mohamedtaherno22-cmyk/MIDI-Keyboard/BOM.csv

Item | Qty | Supplier | Cost/item | Total Cost | link
ESP-32S 30Pin Development Board WiFi Bluetooth with New CP2102 Chip | 1 | RAM electronics | $5.08 | $5.08 | https://www.ram-e-shop.com/shop/kit-esp32-esp32s-30pin-esp-32s-30pin-development-board-wifi-bluetooth-with-new-cp2102-chip-7433
EC11 Rotary Encoder With Push Button Switch 5pin 20mm Silver | 3 | RAM electronics | $0.45 | $1.35 | https://www.ram-e-shop.com/shop/pot-ec11-rotary-5pin-20mm-ec11-rotary-encoder-with-push-button-switch-5pin-20mm-silver-9624
Linear Slide Potentiometer 20KOhm 20mm | 2 | Amazon | $1.45 | $2.90 | https://www.amazon.eg/-/en/Linear-Slide-Potentiometer-20KOhm-20mm/dp/B0CJ885TVL/ref=sr_1_6?sr=8-6
Resistor 10K ohm – 1/4W (2pcs) | 2 | amazon | $0.91 | $1.82 | https://www.amazon.eg/-/en/Resistor-10K-ohm-4W-2pcs/dp/B0CJQ3BYFY/ref=sr_1_8?sr=8-8
(3Pcs) Mechanical Keyboard Switch 5 Pin Cyan Linear 40g Actuation 50M Keystrokes | Mechanical Keyboard Switch Pin Cyan L | 1 | Amazon | $4.06 | $4.06 | https://www.amazon.eg/-/en/Mechanical-Actuation-Keystrokes-enthusiasts-construction/dp/B0GXSY4S7W
(1Pcs) Mechanical Keyboard Switch 5 Pin Cyan Linear 40g Actuation 50M Keystrokes | Mechanical Keyboard Switch Pin Cyan L | 1 | Amazon | $1.92 | $1.92 | https://www.amazon.eg/-/en/Mechanical-Actuation-Keystrokes-enthusiasts-construction/dp/B0GXT298X9
Estimated total shipping | 1 |  |  | $0.00
