mohamedtaherno22-cmyk/MIDI-Keyboard/3DModels/PTA2043.step

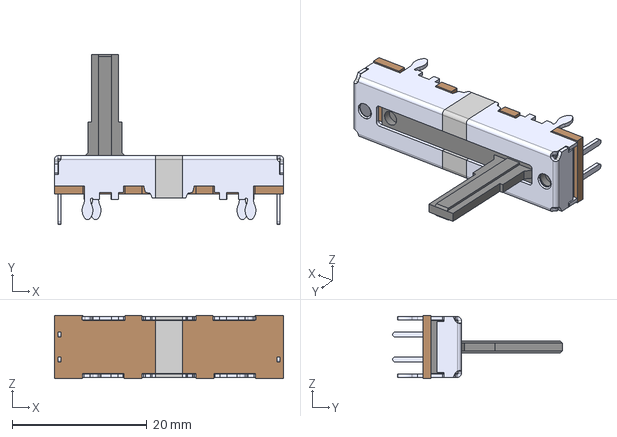
[picture p1: CAD file, 2026-10-25]
3DModels/PTA2043.step
34.0 x 25.2 x 9.40 mm
