mohamedtaherno22-cmyk/MIDI-Keyboard/3DModels/Cherry MX.STEP

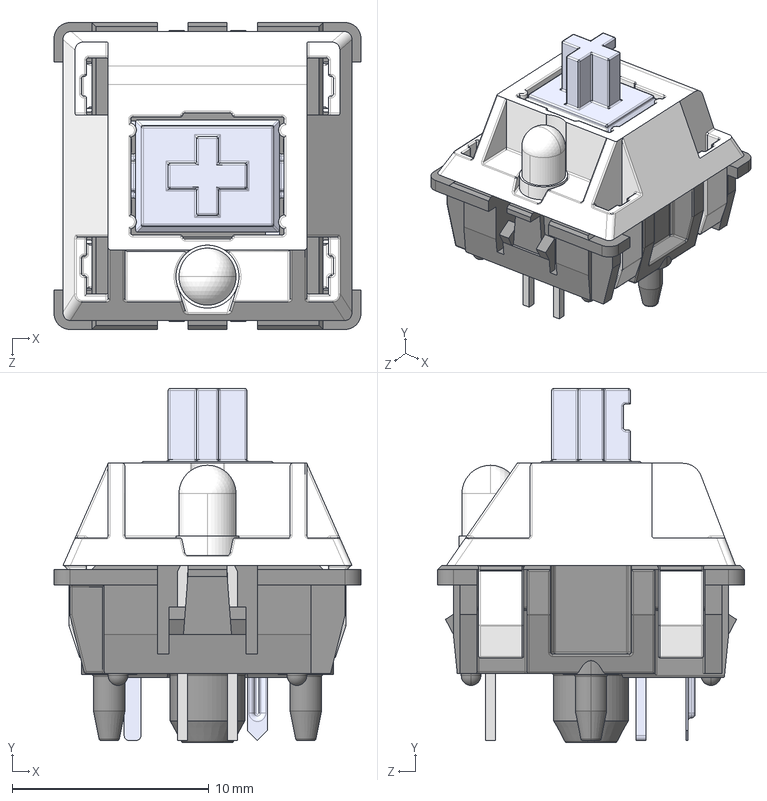
[picture p2: CAD file, 2026-10-25]
3DModels/Cherry MX.STEP
15.6 x 18.0 x 15.6 mm
Bottom
Pulsador
Top
Pieza5^Cherry MX
Pin1
Pin2
Led 3mm_trans
