mohamedtaherno22-cmyk/MIDI-Keyboard/3DModels/usb-micro_esp32_30pinpin.step

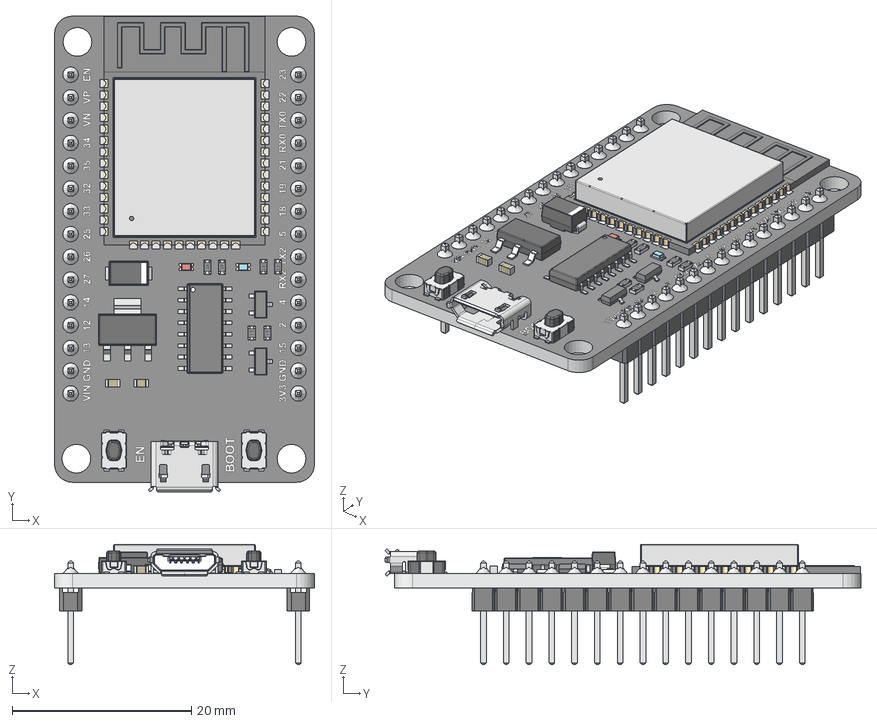
[picture p3: CAD file, 2026-10-25]
3DModels/usb-micro_esp32_30pinpin.step
29.0 x 53.1 x 13.4 mm
690t505-662-010_1
pin
soudures
