mohamedtaherno22-cmyk/MIDI-Keyboard/3DModels/EC11 Rotary Encoder.STEP

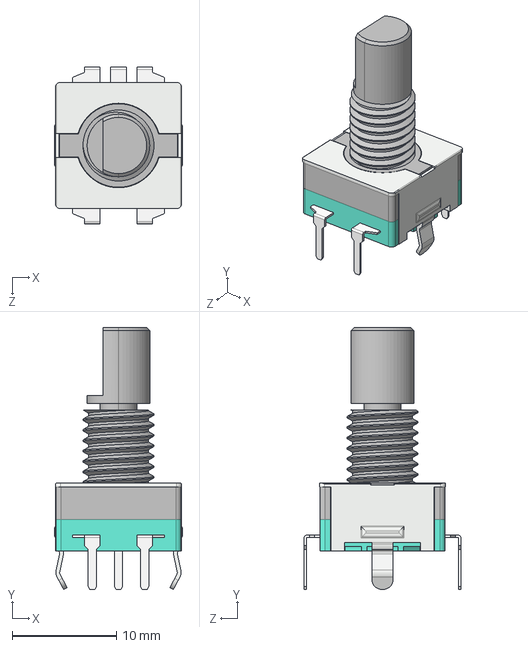
[picture p4: CAD file, 2026-10-25]
3DModels/EC11 Rotary Encoder.STEP
12.3 x 25.1 x 15.0 mm
