mohamedtaherno22-cmyk/MIDI-Keyboard/Schematic & PCB Files/MIDI_Keypad_140mm.kicad_pcb

## KiCad design Schematic & PCB Files/MIDI_Keypad_140mm.kicad_pcb (2026-10-25)

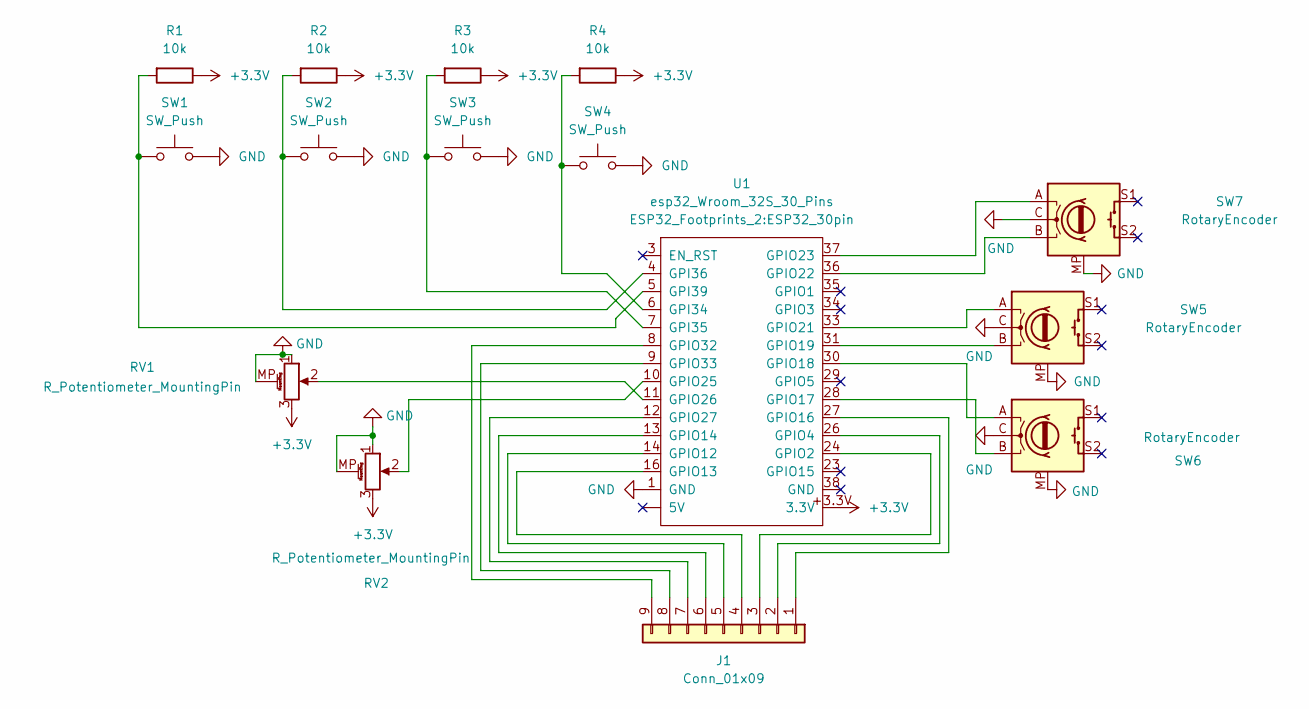
[picture p5: schematic MIDI_Keypad_140mm.kicad_sch]

Parts:
J1: Conn_01x09; Touch Keys
R1, R2, R3, R4: 10k; R_Axial_DIN0207_L6.3mm_D2.5mm_P10.16mm_Horizontal
RV1, RV2: R_Potentiometer_MountingPin; Potentiometer_Bourns_PTA2043_Single_Slide
SW1, SW2, SW3, SW4: SW_Push; SW_Cherry_MX_1.00u_PCB
SW5, SW6, SW7: RotaryEncoder; RotaryEncoder_Alps_EC11E-Switch_Vertical_H20mm
U1: esp32_Wroom_32S_30_Pins; ESP32_30pin

Connections:
+3.3V: R1.1, R2.1, R3.1, R4.1, RV1.3, RV2.3, U1.+3.3V (3.3V)
GND: RV1.1, RV1.MP (MountPin), RV2.1, RV2.MP (MountPin), SW1.2, SW2.2, SW3.2, SW4.2, SW5.C, SW5.MP, SW6.C, SW6.MP, SW7.C, SW7.MP, U1.1 (GND)
unnamed: J1.1, U1.27 (GPIO16)
unnamed: J1.2, U1.26 (GPIO4)
unnamed: J1.3, U1.24 (GPIO2)
unnamed: J1.4, U1.16 (GPIO13)
unnamed: J1.5, U1.14 (GPIO12)
unnamed: J1.6, U1.13 (GPIO14)
unnamed: J1.7, U1.12 (GPIO27)
unnamed: J1.8, U1.9 (GPIO33)
unnamed: J1.9, U1.8 (GPIO32)
unnamed: R4.2, SW4.1, U1.6 (GPI34)
unnamed: R3.2, SW3.1, U1.7 (GPI35)
unnamed: R2.2, SW2.1, U1.4 (GPI36)
unnamed: R1.2, SW1.1, U1.5 (GPI39)
unnamed: SW6.B, U1.28 (GPIO17)
unnamed: SW6.A, U1.30 (GPIO18)
unnamed: SW5.B, U1.31 (GPIO19)
unnamed: SW5.A, U1.33 (GPIO21)
unnamed: SW7.B, U1.36 (GPIO22)
unnamed: SW7.A, U1.37 (GPIO23)
unnamed: RV2.2, U1.10 (GPIO25)
unnamed: RV1.2, U1.11 (GPIO26)

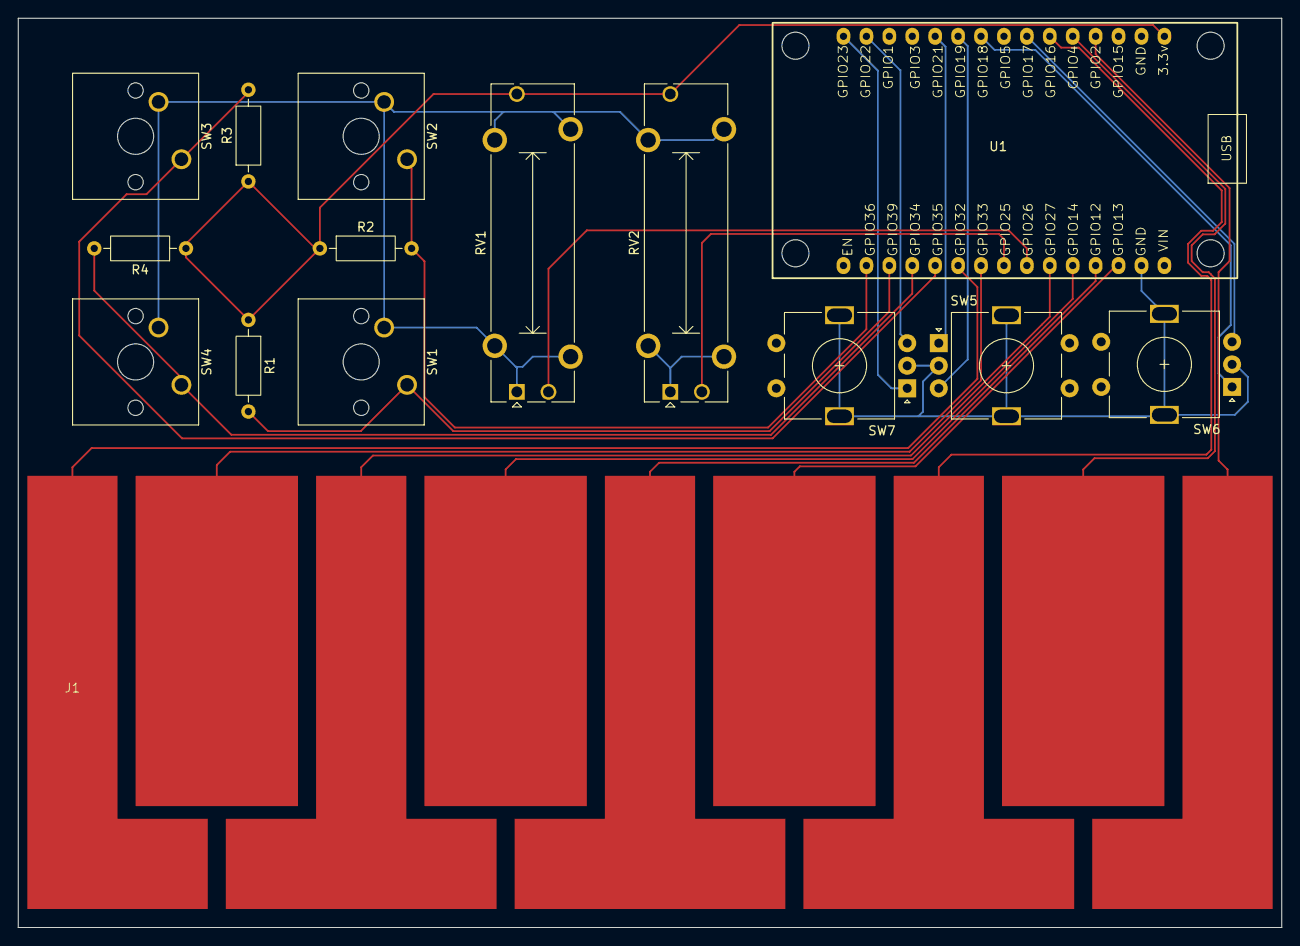
[picture p6: board MIDI_Keypad_140mm.kicad_pcb from above]

Board: 2 copper layers, 140.0 x 100.8 mm, 15 parts (0 on the bottom side), 23 nets.
