mohamedtaherno22-cmyk/MIDI-Keyboard/JOURNAL.md

# Midi Keyboard – devlog

<!-- Generated by Half Life from project cmvf5efq30aw801rct4f9qcgi. Edits here are overwritten on the next sync. -->
<!-- Generated: 2026-10-25T17:37:09.938Z -->

> [!NOTE]
> This devlog is mirrored from [Half Life](https://halflife.hackclub.com) – [open the project](https://halflife.hackclub.com/projects/cmvf5efq30aw801rct4f9qcgi). Editing it here will not change the platform's copy, and the next sync overwrites this file.

> Learn PCB design by creating your own custom MIDI keypad with switches, sliders, rotary encoders, neopixels and capacitive touch!

| Week | Tier | Hours logged | Entries |
| --- | --- | --- | --- |
| Week 3 | Tier 1 | 18h | 3 |

## Contents

1. [2026-10-23 – 22 OCT-OCT24: PCB design.](#2026-10-23-22-oct-oct24-pcb-design)
2. [2026-10-24 – In the last session i faced a problem routing the PCB, the connections were mixed up, i traced the problem to the custom ESP32 Footprint i downloaded, all the pins are mixed up](#2026-10-24-in-the-last-session-i-faced-a-problem-routing-the)
3. [2026-10-25 – OCT 25: 100 mm x 100 mm PCB design](#2026-10-25-oct-25-100-mm-x-100-mm-pcb-design)

## Design

### 2026-10-23 – 22 OCT-OCT24: PCB design.

**12h**

22 OCT-OCT24: PCB design.

The first thing I did this time was open the guide created by Hack Club members. I downloaded symbols, footprints, and and 3d models required for the project and successfully added them to KiCad.

With this, I can start designing the schematic, but before that I had to make a choice: either use the XIAO ESP32-S3 or the Waveshare ESP32-S3-Zero. I found the S3 on Amazon. So I am sticking with it for now.

Next, I am going to choose the other parts of the keypad: Capacitive Touch Keys, Low-Profile Switches, EC11 Rotary Encoder, Bourns Slide Potentiometer, which are the same parts used in the guide; however, I am going to change the orientation and number of parts. My vision is to create a MIDI keypad similar to AKAI MPK Mini MK3. However, after some research, the Mini MK3 has too many keys, which are way more than the number of GPIO pins on the Esp32. So I will be reducing the number of keys by quite a bit. I also found this keypad (nanoKEY 2 - Black KORG), which has a very cool configuration, in my opinion.



I will be using half the Keys on this board, which are about 13 keys. Adding to the other switches and other components, the number of required GPIO pins is more than what my microcontroller can handle, so I will be searching for another one with more GPIO pins.

I found the ESP-WROOM-32 dev kit to be perfect, as it has 38 pins, which is quite a lot. But I still need to download the schematic and footprint & 3d model for this board. After a while, I found everything on GitHub. However, it has old .lib files that I can't add to my current KiCad version. I spent 30 minutes trying to fix this problem, with no success, until I accidentally pressed the arrow next to Add existing library, which showed me a menu containing the option to select a legacy library.

https://github.com/MightyMirko/esp32_devkit_38Pins



I spent a while searching for this board on Amazon and other places, but couldn't find it. For now, I will just connect the parts and figure it out this out later.

I found the 30-pin ESP-32S 30Pin Development Board on an online store. So, I am going with this one finally. I have spent some time modifying the schematic of the other board to match this one; this is the result.



This board supports 9 capacitive touch keys; I was planning on adding 13 of them, but I wasn't lucky, ig. I connected them to Pins (8,9,12,13,14,16,23,24,26).

The next thing to add is 3 rotary encoders, 4 switches, and 2 slide potentiometers. And here is the schematic and connections



I modified the schematic a bit, and since the switches are connected to input-only pins, a resistor must be connected in parallel with the switches, so I added just that and cleaned the schematic a bit. With this, the schematic is done for now.



Before proceeding to design the PCB, I will assign the footprints first. The footprint for the 30 ESP32-WROOM-32S was missing, so I downloaded it from GitHub

https://github.com/syauqibilfaqih/ESP32-DevKit-V1-DOIT

now for the rest of the components,

 EC11 rotary encoder → Rotary_Encoder:RotaryEncoder_Alps_EC11E-Switch_Vertical_H20mm)

the sliding Potentiometers, I chose a 20 mm potentiometer for the project. →
Potentiometer_THT:Potentiometer_Bourns_PTA2043_Single_Slide

10k resitors → R_Axial_DIN0207_L6.3mm_D2.5mm_P10.16mm_Horizontal

For the buttons, I found some mechanical keyboard switches that are perfect.
Button_Switch_Keyboard:SW_Cherry_MX_1.00u_PCB

And finally, for the capacitive touchpad, this will be designed separately. I will organize all the components, as I need some dimensions to start on the pad design.


this is the orientation of the pcb for now, and it covers about 145 x 50 mm, with this in mind, i will create the foot pint the same size as the pacb or smaller by 20mm, i really liked the design of the nano key 2, but i don't think it will suit the project, as i think it is more of a switch than a key, and also i found this keypad image, which looks absolutly fantasitc.

Designing the footprint for the capacitive keys was a pain in the head, i spent alot of time working on it, i came up with many designs but liked none of them, here are some of them









The Final Design


Next on the list is routing the PCB. While routing the PCB, the traces to the pads weren't working correctly. I am exhausted right now, so I will just leave the rest of the PCB design for the next session.


Links for the parts
https://www.ram-e-shop.com/shop/kit-esp32-esp32s-30pin-esp-32s-30pin-development-board-wifi-bluetooth-with-new-cp2102-chip-7433
https://www.ram-e-shop.com/shop/pot-ec11-rotary-5pin-20mm-ec11-rotary-encoder-with-push-button-switch-5pin-20mm-silver-9624
https://www.amazon.eg/-/en/Linear-Slide-Potentiometer-20KOhm-20mm/dp/B0CJ885TVL/ref=sr_1_6?sr=8-6
https://www.amazon.eg/-/en/Resistor-10K-ohm-4W-2pcs/dp/B0CJQ3BYFY/ref=sr_1_8?sr=8-8
(1Pcs) Mechanical Keyboard Switch 5 Pin Cyan Linear 40g Actuation 50M Keystrokes | Mechanical Keyboard Switch Pin Cyan Linear designed enthusiasts | Durable construction | Easy

TL;DR: i am almost done with the Project, the parts are done, schematic, and the PCB except for the routing.

Total Time Spent: 12h

### 2026-10-24 – In the last session i faced a problem routing the PCB, the connections were mixed up, i traced the problem to the custom ESP32 Footprint i downloaded, all the pins are mixed up

**4h**

In the last session i faced a problem routing the PCB, the connections were mixed up, i traced the problem to the custom ESP32 Footprint i downloaded, all the pins are mixed up



fixing this problem was simple, I just changed the Pad number in the Footprint to match that of schematic. i also changed the capacitive touch key footprint to be from 9 to 1 instead making the lower keys from 1 to 5 and the upper keys from 6 to 9. basically i just adjusted it to match the schematic, here is a screenshot after routing the keys.



I continued routing the PCB, I faced some problems with the components, but i used the shcematic to wire them diffrently, basicly i was inversing the GPIO pins of the switches, encoders and so on. I had some problems with the power pin having no name, but naming it to +3.3V in both the symbol editor and the Footprint editor fixed the problem. With this done, the PCB routing is fully finished, Here is the final result.



I Spoke too soon, checking the DRC revealed 27 errors, which is a lot. However, almost all of them are caused by the capacitive touch keys' custom footprint, and after checking, the same errors are present in the hack club guide, and I think i should just Ignore those.



now its time for the 3d models, the process was tedious but straight forward. and something i should mention is the model for the 20mm slider was rotated in a strange manner, so I edited it in fusion. after fixing the model, It was another model for the 15 mm slider, I tired editing the model in fusion to be 20cm but it came out of proportions, how i have no Idea, i redid the whole thing again, this time i succeeded, YAAAY. finally for the ESP 32 i found this beautiful model here.
https://www.printables.com/model/1362332-esp32-devkit-v1-board-30-pin/files

IMAGES

PCB before 3D models


my edited Fusion Model for the slider


PCB 3d Model


And that is it for the 140 mm x 100mm keypad, next i will create a keypad less than 100mm x 100mm, so yeah, I am doing all this again.

TL;DR: PCB Routing is done, 3D Model is done.

Total Time Spent: 4 hours

### 2026-10-25 – OCT 25: 100 mm x 100 mm PCB design

**2h**

OCT 25: 100 mm x 100 mm PCB design

The previous PCB model was 140mm x 90 mm, which is much more expensive to manufacture, so I decided to make a smaller version; the process was identical to the previous PCB. I reorganized the components, putting the potentiometers in the middle. I also shrunk the footprint for the keys to match the board. This is a screenshot during the first stages of routing.



Finished PCB. Routing this PCB was much harder than the other version, as the sliders on the bottom didn't give me much space to work with, and adding that to the space that was cut off, you could say it wasn't easy at all. However, I am happy with the current result.

3D model

This was the result after I ran the DRC; all of those errors are caused by the capacitive touch keys' footprint. So I think it's safe to ignore them for now

I also fabricated both PCBs, and now they are ready to be ordered.

TL;DR: The 100mm x 100mm PCB is finished.

Total Time Spent: 2 Hours.
