mohamedtaherno22-cmyk/MIDI-Keyboard/(commit log)

2026-10-22 Sync Midi Keyboard from Half Life
    [BOM.csv]
2026-10-25 Rename MIDI_Keypad.kicad_pro to Schematic & PCB FIles/MIDI_Keypad.kicad_pro
2026-10-25 Rename MIDI_Keypad.kicad_sch to Schematic & PCB Files/MIDI_Keypad.kicad_sch
    [MIDI_Keypad.kicad_sch]
2026-10-25 Rename MIDI_Keypad_140mm.kicad_pcb to Schematic & PCB Files/MIDI_Keypad_140mm.kicad_pcb
    [MIDI_Keypad_140mm.kicad_pcb]
2026-10-25 Rename MIDI_Keypad_140mm.kicad_pro to Schematic & PCB Files/MIDI_Keypad_140mm.kicad_pro
2026-10-25 Rename MIDI_Keypad_140mm.kicad_sch to Schematic & PCB Files/MIDI_Keypad_140mm.kicad_sch
    [MIDI_Keypad_140mm.kicad_sch]
2026-10-25 Rename esp32_30pin_revised.kicad_sym to ESP32S Footprint & Schematic/esp32_30pin_revised.kicad_sym
2026-10-25 Rename ESP32_Footprints.pretty/ESP32_30pin.kicad_mod to ESP32S Footprint & Schematice/ESP32_Footprints.pretty/ESP32_30pin.kicad_mod
